PunderWorks/DroidPowerSense/PCB/production/bom/DroidPowerSense-bom.csv

Refs | Quantity | Value | Footprint | MF | MPN | LCSC | Mouser | DigiKey | Hand | DNP
R10,R12,R14,R17,R18 | 5 | 100kΩ | Resistor_SMD:R_0603_1608Metric | YAGEO | RC0603FR-07100KL | C14675 | 603-RC0603FR-07100KL | 311-100KHRCT-ND
C1,C10,C13,C14,C15,C2,C4,C5,C8 | 9 | 100nF | Capacitor_SMD:C_0603_1608Metric | Murata Electronics | GRM188R72A104KA35D | C77058 | 81-GRM188R72A104KA35 | 490-3285-1-ND
R15,R20,R23,R24,R25,R27,R5,R7,R9 | 9 | 10kΩ | Resistor_SMD:R_0603_1608Metric | YAGEO | RC0603FR-0710KL | C98220 | 603-RC0603FR-0710KL | 311-10.0KHRCT-ND
C9 | 1 | 10nF | Capacitor_SMD:C_0603_1608Metric | Samsung Electro-Mechanics | CL10B103KB8NNNC | C1589 | 187-CL10B103KB8NNNC | 1276-1009-1-ND
C11,C12,C6,C7 | 4 | 10µF | Capacitor_SMD:C_1206_3216Metric | Samsung Electro-Mechanics | CL31A106KBHNNNE | C13585 | 187-CL31A106KBHNNNE | 1276-2876-1-ND
L1 | 1 | 10µH | Inductor_SMD:L_Bourns_SRN6045TA | Bourns | SRN6045TA-100M | C2046332 | 652-SRN6045TA-100M | SRN6045TA-100MCT-ND
R28 | 1 | 120Ω | Resistor_SMD:R_0805_2012Metric | YAGEO | RC0805FR-07120RL | C114245 | 603-RC0805FR-07120RL | 311-120CRCT-ND
R8 | 1 | 180kΩ | Resistor_SMD:R_0603_1608Metric | YAGEO | RC0603FR-07180KL | C123419 | 603-RC0603FR-07180KL | 311-180KHRCT-ND
D4 | 1 | 1N4148W-TP | Diode_SMD:D_SOD-123 | Micro Commercial Components | 1N4148W-TP | C77978 | 833-1N4148W-TP | 1N4148W-TPMSCT-ND
R2,R26,R30 | 3 | 1kΩ | Resistor_SMD:R_0603_1608Metric | YAGEO | RC0603FR-071KL | C22548 | 603-RC0603FR-071KL | 311-1.00KHRCT-ND
R13 | 1 | 1mΩ | Resistor_SMD:R_2512_6332Metric | Bourns | CSS2H-2512R-1L00F | C4175647 | 652-CSS2H-2512R1L00F | CSS2H-2512R-1L00FCT-ND
J10,J11 | 2 | 1x9 socket | DroidPowerSense:PinSocket_1x09_P2.54mm_Vertical_NoPads | Sullins Connector Solutions | PPPC091LFBN-RC | C5362844 |  | S7042-ND | Yes | Yes
R1 | 1 | 2.2kΩ | Resistor_SMD:R_0603_1608Metric | YAGEO | RC0603FR-072K2L | C114662 | 603-RC0603FR-072K2L | 311-2.20KHRCT-ND
C3 | 1 | 2.2µF | Capacitor_SMD:C_0603_1608Metric | Samsung Electro-Mechanics | CL10A225KO8NNNC | C23630 | 187-CL10A225KO8NNNC | 1276-1119-1-ND
R16 | 1 | 3.3Ω | Resistor_SMD:R_1206_3216Metric | YAGEO | RC1206FR-073R3L | C137283 | 603-RC1206FR-073R3L | 311-3.30FRCT-ND
R4,R6 | 2 | 33kΩ | Resistor_SMD:R_0603_1608Metric | YAGEO | RC0603FR-0733KL | C126359 | 603-RC0603FR-0733KL | 311-33.0KHRCT-ND
J9 | 1 | 3V3 | VIO | 5V | Connector_PinHeader_2.54mm:PinHeader_1x03_P2.54mm_Vertical | Würth Elektronik | 61300311121 | C2915006 | 710-61300311121 | 732-5316-ND | Yes | Yes
R21,R22,R29,R31,R32 | 5 | 4.7kΩ | Resistor_SMD:R_0603_1608Metric | YAGEO | RC0603FR-074K7L | C99782 | 603-RC0603FR-074K7L | 311-4.70KHRCT-ND
R11,R3 | 2 | 47kΩ | Resistor_SMD:R_0603_1608Metric | YAGEO | RC0603FR-0747KL | C105579 | 603-RC0603FR-0747KL | 311-47.0KHRCT-ND
R19 | 1 | 56.2kΩ | Resistor_SMD:R_0603_1608Metric | YAGEO | RC0603FR-0756K2L | C482887 | 603-RC0603FR-0756K2L | 311-56.2KHRCT-ND
D2,D3 | 2 | B160-13-F | Diode_SMD:D_SMA | Diodes Incorporated | B160-13-F | C24784 | 621-B160-F | B160-FDICT-ND
D7 | 1 | B360A-13-F | Diode_SMD:D_SMA | Diodes Incorporated | B360A-13-F | C94193 | 621-B360A-F | B360A-FDICT-ND
D5 | 1 | B560C-13-F | Diode_SMD:D_SMC | Diodes Incorporated | B560C-13-F | C85100 | 621-B560C-F | B560C-FDICT-ND
Q4,Q5,Q6,Q7 | 4 | BSS138 | Package_TO_SOT_SMD:SOT-23 | Diodes Incorporated | BSS138-7-F | C40912 | 621-BSS138-7-F | BSS138-7-FDICT-ND
J7 | 1 | CAN_TERM | Connector_PinHeader_2.54mm:PinHeader_1x02_P2.54mm_Vertical | Würth Elektronik | 61300211121 | C2915055 | 710-61300211121 | 732-5315-ND | Yes | Yes
J4 | 1 | CIRCUIT_ID | Connector_PinHeader_2.54mm:PinHeader_1x02_P2.54mm_Vertical | Würth Elektronik | 61300211121 | C2915055 | 710-61300211121 | 732-5315-ND | Yes | Yes
Q1,Q2 | 2 | CSD18532Q5B | VSON-CLIP-8 5x6mm (DNK) | Package_TO_SOT_SMD:TDSON-8-1 | Texas Instruments | CSD18532Q5B | C882766 | 595-CSD18532Q5B | 296-42322-1-ND
U4 | 1 | ESP32-C5-Zero-M | DroidPowerSense:Waveshare_ESP32-C5-Zero-M_Socketed | Waveshare | ESP32-C5-Zero-M |  |  |  | Yes | Yes
U2 | 1 | INA237 | Package_SO:TSSOP-10_3x3mm_P0.5mm | Texas Instruments | INA237AIDGSR | C2864837 | 595-INA237AIDGSR | 296-INA237AIDGSRCT-ND
J5,J6,J8 | 3 | JST XH 2-pin | Connector_JST:JST_XH_B2B-XH-A_1x02_P2.50mm_Vertical | JST | B2B-XH-A(LF)(SN) | C158012 |  | 455-2247-ND | Yes | Yes
J3 | 1 | JST XH 4-pin | Connector_JST:JST_XH_B4B-XH-A_1x04_P2.50mm_Vertical | JST | B4B-XH-A(LF)(SN) | C144395 | 306-B4BXHALFSN |  | Yes | Yes
SH1,SH2,SH3 | 3 | Jumper shunt for 2.54mm PinHeader | DroidPowerSense:BOM_Only_JumperShunt | Würth Elektronik | 60900213421 |  | 710-60900213421 | 732-2678-ND | Yes | Yes
U1 | 1 | LM5060MM/NOPB | Package_SO:TSSOP-10_3x3mm_P0.5mm | Texas Instruments | LM5060MM/NOPB | C74456 | 926-LM5060MM/NOPB | LM5060MM/NOPBCT-ND
U3 | 1 | LMR14030SDDAR | HSOIC-8 PowerPAD (DDA) | Package_SO:TI_SO-PowerPAD-8_ThermalVias | Texas Instruments | LMR14030SDDAR | C182078 | 595-LMR14030SDDAR | 296-42492-1-ND
D8 | 1 | LTST-C190KGKT | LED_SMD:LED_0603_1608Metric | Lite-On | LTST-C190KGKT | C125094 | 859-LTST-C190KGKT | 160-1435-1-ND
Q3 | 1 | MMBT3904 | Package_TO_SOT_SMD:SOT-23 | onsemi | MMBT3904LT1G | C81464 | 863-MMBT3904LT1G | MMBT3904LT1GOSCT-ND
D6 | 1 | SMBJ33CA-13-F | Diode_SMD:D_SMB | Diodes Incorporated | SMBJ33CA-13-F | C135068 | 621-SMBJ33CA-F | SMBJ33CA-FDICT-ND
D1 | 1 | SMCJ33CA-13-F | Diode_SMD:D_SMC | Diodes Incorporated | SMCJ33CA-13-F | C135163 | 621-SMCJ33CA-F | SMCJ33CA-FDICT-ND
U5 | 1 | TCAN334G | Package_SO:SOIC-8_3.9x4.9mm_P1.27mm | Texas Instruments | TCAN334GDR | C189939 | 595-TCAN334GDR | 296-43570-1-ND
J2 | 1 | XT60PW-F | DroidPowerSense:AMASS_XT60PW-F_1x02_P7.20mm_Horizontal | Amass | XT60PW-F | C428722 |  | 4786-XT60PW-F-ND | Yes | Yes
J1 | 1 | XT60PW-M | DroidPowerSense:AMASS_XT60PW-M_1x02_P7.20mm_Horizontal | Amass | XT60PW-M | C98732 |  | 4786-XT60PW-M-ND | Yes | Yes
