PunderWorks/DroidPowerSense/PCB/DroidPowerSense.kicad_pcb

## KiCad design PCB/DroidPowerSense.kicad_pcb (2026-11-10)

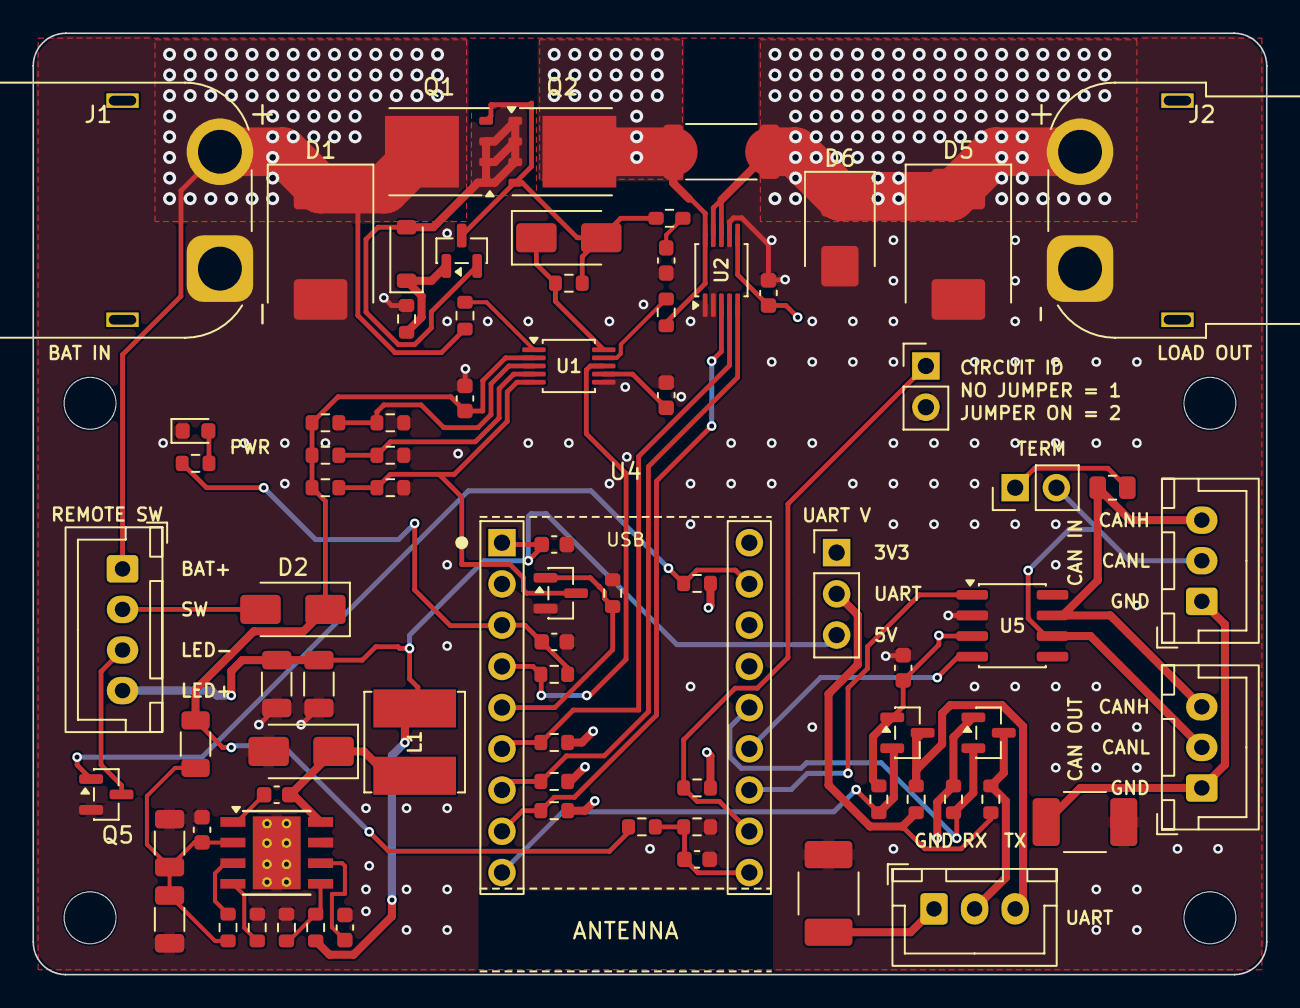
[picture p3: board DroidPowerSense.kicad_pcb from above]

Board: 4 copper layers, 76.0 x 58.0 mm, 89 parts (1 on the bottom side), 48 nets.

Parts:
C1, C2, C4, C5, C8, C10, C13, C14, C15: 100nF; C_0603_1608Metric
C3: 2.2µF; C_0603_1608Metric
C6, C7, C11, C12: 10µF; C_1206_3216Metric
C9: 10nF; C_0603_1608Metric
D1: SMCJ33CA-13-F; D_SMC
D2, D3: B160-13-F; D_SMA
D4: 1N4148W-TP; D_SOD-123
D5: B560C-13-F; D_SMC
D6: SMBJ33CA-13-F; D_SMB
D7: B360A-13-F; D_SMA
D8: LTST-C190KGKT; LED_0603_1608Metric
F1, F2: MF-MSMF014/60X-2; Bourns_MF-MSMF_1812_Style2
H1, H2, H3, H4: M3; MountingHole_3.2mm_M3
J1: XT60PW-M; AMASS_XT60PW-M_1x02_P7.20mm_Horizontal
J2: XT60PW-F; AMASS_XT60PW-F_1x02_P7.20mm_Horizontal
J3: JST XH 4-pin; JST_XH_B4B-XH-A_1x04_P2.50mm_Vertical
J4: CIRCUIT_ID; PinHeader_1x02_P2.54mm_Vertical
J5, J6, J8: JST XH 3-pin; JST_XH_B3B-XH-A_1x03_P2.50mm_Vertical
J7: CAN_TERM; PinHeader_1x02_P2.54mm_Vertical
J9: 3V3 | VIO | 5V; PinHeader_1x03_P2.54mm_Vertical
J10, J11: 1x9 socket; PinSocket_1x09_P2.54mm_Vertical_NoPads
L1: 10µH; L_Bourns_SRN6045TA
LOGO**: PunderWorks_Logo_14mm
Q1, Q2: CSD18532Q5B | VSON-CLIP-8 5x6mm (DNK); TDSON-8-1
Q3: MMBT3904; SOT-23
Q4, Q5, Q6, Q7: BSS138; SOT-23
R1: 2.2kΩ; R_0603_1608Metric
R2, R26, R30: 1kΩ; R_0603_1608Metric
R3, R11: 47kΩ; R_0603_1608Metric
R4, R6: 33kΩ; R_0603_1608Metric
R5, R7, R9, R15, R20, R23, R24, R25, R27: 10kΩ; R_0603_1608Metric
R8: 180kΩ; R_0603_1608Metric
R10, R12, R14, R17, R18: 100kΩ; R_0603_1608Metric
R13: 1mΩ; R_2512_6332Metric
R16: 3.3Ω; R_1206_3216Metric
R19: 56.2kΩ; R_0603_1608Metric
R21, R22, R29, R31, R32: 4.7kΩ; R_0603_1608Metric
R28: 120Ω; R_0805_2012Metric
SH1, SH2, SH3: Jumper shunt for 2.54mm PinHeader; BOM_Only_JumperShunt
U1: LM5060MM/NOPB; TSSOP-10_3x3mm_P0.5mm
U2: INA237; TSSOP-10_3x3mm_P0.5mm
U3: LMR14030SDDAR | HSOIC-8 PowerPAD (DDA); TI_SO-PowerPAD-8_ThermalVias
U4: ESP32-C5-Zero-M; Waveshare_ESP32-C5-Zero-M_Socketed
U5: TCAN334G; SOIC-8_3.9x4.9mm_P1.27mm

Connections:
+3V3: C4.1, C14.1, C15.1, J9.1, Q6.1, Q7.1, R21.2, R22.2, R23.2, R24.2, R25.2, R26.1, R27.2, R29.2, R31.2, U2.6, U4.3, U5.3
+5V: C11.1, C12.1, C13.1, J3.4, J9.3, L1.2, R19.1, U4.1
BUCK_BOOT: C10.1, U3.1
BUCK_EN: R17.2, U3.3
BUCK_FB: R19.2, R20.1, U3.5
BUCK_RT: R18.1, U3.4
BUCK_SS: C9.1, U3.6
BUCK_SW: C10.2, D7.1, L1.1, U3.8
BUCK_VIN: C6.1, C7.1, C8.1, R16.2, R17.1, U3.2
CANH: J5.3, J6.3, R28.1, U5.7
CANL: J5.2, J6.2, J7.2, U5.6
CAN_GND: F1.1, J5.1, J6.1
CAN_RX: U4.13, U5.4
CAN_TX: U4.12, U5.1
CIRCUIT_ID: J4.1, R25.1, U4.11
GATE_C: C2.1, R2.2
GATE_DRV: D3.1, R1.1, U1.10
GATE_FET: D3.2, Q1.4, Q2.4, Q3.3, R1.2, R2.1
GND: C1.2, C2.2, C3.2, C4.2, C5.2, C6.2, C7.2, C8.2, C9.2, C11.2, C12.2, C13.2, C14.2, C15.2, D1.2, D5.2, D6.2, D7.2, D8.1, F1.2, F2.2, J1.1, J2.1, J4.2, Q4.2, Q5.2, R3.2, R7.2, R9.2, R11.2, R12.2, R15.2, R18.2, R20.2, U1.6, U2.1, U2.2, U2.7, U3.7, U3.9, U4.2, U5.2
I2C_SCL: R22.1, U2.5, U4.7
I2C_SDA: R21.1, U2.4, U4.6
INA_ALERT: R23.1, U2.3, U4.8
unnamed: J7.1, R28.2
PROT_EN: Q4.3, R10.2, R11.1, U1.5
PROT_OUT: R5.2, U1.9
PROT_OVP: R8.2, R9.1, U1.3
PROT_SENSE: R4.2, U1.1
PROT_TIMER: C3.1, U1.7
PROT_UVLO: R6.2, R7.1, U1.4
PWR_CUTOFF: Q4.1, R12.1, U4.5
PWR_LED_A: D8.2, R26.2
PWR_PGOOD: R24.1, U1.8, U4.4
REV_BASE: D4.1, Q3.1, R3.1
SW_LED_EN: Q5.1, R27.1, U4.17
SW_LED_K: J3.3, Q5.3
UART_GND: F2.1, J8.1
UART_RX: J8.2, Q7.3, R32.2
UART_RX_3V3: Q7.2, R31.1, U4.14
UART_TX: J8.3, Q6.3, R30.2
UART_TX_3V3: Q6.2, R29.1, U4.9
UART_VIO: J9.2, R30.1, R32.1
VBAT_ADC: C5.1, R14.2, R15.1, U4.10
VBAT_IN: D1.1, J1.2, J3.1, Q1.5, R4.1
VOUT: D5.1, D6.1, J2.2, R13.2, U2.8, U2.9
VSW_CTRL: C1.1, D2.1, R6.1, R8.1, R10.1, R14.1, R16.1, U1.2
VSW_MID: D4.2, Q1.1, Q1.2, Q1.3, Q2.1, Q2.2, Q2.3, Q3.2
VSW_OUT: Q2.5, R5.1, R13.1, U2.10
VSW_RAW: D2.2, J3.2
