PunderWorks/DroidPowerSense/(commit log)

2026-11-07 Initial DroidPowerSense hardware design
    Inline 9-32 V battery sense and protection board for droid builds:
    XT60 in/out, LM5060 + back-to-back CSD18532Q5B switch with zero
    off-state drain, INA226 on a 1 mOhm shunt, LMR14030 5 V buck,
    Waveshare ESP32-C5-Zero, TCAN334G CAN FD and level-shifted UART.
    - Stackup KDL design (PCB/stackup) with the synced 4-layer KiCad board,
    custom footprints, 3D models and manufacturer datasheets
    - Remote switch connector J3 is a 4-pin JST-XH (BAT+, SW, LED-, LED+)
    supporting lit-when-on switches; Q_LED on IO12 drives the light
    - Silkscreen: pin functions in line with every JST pin, CAN IN / CAN
    OUT markings, plain-language circuit ID jumper instructions
    - n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
2026-11-07 Move CI actions off deprecated Node 20 (#2)
    actions/checkout v4 -> v7 and dorny/paths-filter v3 -> v4; both run on
    node24. checkout v7's breaking change only blocks fork checkouts under
    pull_request_target / workflow_run, which this workflow doesn't use.
2026-11-08 Compact the board to 70 x 50 mm with the ESP32 on sockets (#3)
    * Compact the board to 70 x 50 mm with the ESP32 on sockets
    Placement and pours for a 70 x 50 mm board (was 90 x 66). Signal routing
    is left to be done by hand in KiCad.
    - ESP32-C5-Zero-M (pre-soldered headers) in two 1x9 sockets (Sullins
    PPPC091LFBN-RC): the module sits ~11 mm up, so USB-C clears the board,
    low parts fit under it, and it can be swapped. The sockets are pinless
    BOM parts sharing the module footprint's holes.
    - XT60 bodies overhang the side edges ~5 mm so the TVS, FETs, shunt and
    flyback diode fit in one row between them.
    - Power pours on F.Cu/In2.Cu/B.Cu with 85 stitching vias, GND planes,
    In2 VSW_CTR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
2026-11-08 Validate power switch and UART level shifter with SPICE and SOA models (#4)
    - Implement soa.py and test_soa.py: Safe Operating Area power evaluation
    and thermal moving-window integrator for CSD18532Q5B and SMBJ33CA
    transient curves with 10 unit tests.
    - Upgrade power_switch_sim.py: LM5060 charge pump and fault latch models
    covering sw_open, turn_on, mcu_cutoff, reverse_pol, inrush into
    capacitive loads (100 uF to 10 mF), hot-FET 30 A continuous margin,
    120 A overload vs dead short, and motor regeneration back-EMF.
    - Implement uart_shifter_sim.py: bidirectional BSS138 level shifter
    verification across 3.3 V / 5.0 V VIO, threshold corners, 115.2 kbps
    and 1.0 Mbps, and cable capac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
2026-11-08 hardware: add gate dV/dt slew components, update R_SENSE and C_TIMER (#5)
    - Add gate dV/dt network: C_GATE (220 nF 50V X7R 0603) and R_GATE_C (1 kΩ 0603)
    between GATE_FET and GND to control gate slew rate and limit capacitive inrush.
    - Update R_SENSE to 33 kΩ to clear 30 A continuous rating under worst-case 100°C
    hot FET R_DS(on) without false V_DS trips.
    - Update C_TIMER to 2.2 µF to accommodate gate soft-start into large capacitor
    banks without timing out into a fault.
    - Sync and route changes in PCB/DroidPowerSense.kicad_pcb with 0 DRC violations
    and 0 unconnected items.
    - Update baseline VALUES in scripts/spice/power_switch_sim.py and documentation in
    PCB/README.md.
2026-11-08 Fix pre-fab review findings and add fab files (#6)
    * Fix pre-fab review findings and add fab files
    Start-up fault: C_GATE 220 nF could let the LM5060 start-up timer expire
    before the gate finished at 32 V (worst case 0.55 s gate ramp vs 0.48 s
    timer). C_GATE is now 100 nF / 100 V (0.25 s); every 100 nF on the board
    uses the 100 V part. Load capacitance is rated to 4.7 mF at 32 V.
    Overvoltage exposure:
    - INA226 -> INA237 (85 V common-mode, same DGS pinout, A0/A1 to GND).
    - R_BUCK_IN 3.3 Ohm ahead of the LMR14030 input capacitors (new BUCK_VIN
    net) filters surges above its 44 V VIN/EN rating.
    Board:
    - Physical stackup corrected to the 6-layer 1.6 mm build.
    - Board name, revision and date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
2026-11-08 Refill zones and regenerate fab files from the refilled board (#7)
    The board committed in #6 carried pour fills from before R_BUCK_IN and
    the BUCK_VIN re-route: the edit scripts saved without refilling, and DRC
    only refilled in memory. kicad-cli plots stored fills, so all six copper
    Gerbers in PCB/production/ were stale. Refilled with kicad-cli (identical
    to KiCad's own refill), DRC 0/0, and every fab file regenerated. README:
    refill-and-save is now the first step of the regenerate commands.
2026-11-08 Confirm the ESP32 socket height from Sullins' catalog (#8)
    PPPC091LFBN-RC: .335" [8.50 mm] insulator, 6.0 mm insertion depth,
    Ø1.02 mm recommended hole (catalog p. 114-115, now in datasheets/).
    Replaces the README note that the height was inferred from the part
    number.
2026-11-08 Widen the last 0.18 mm tracks to 0.2 mm and regenerate fab files (#9)
    The I²C pair from the INA237 and the B.Cu INA_ALERT run were re-routed
    so every track is at least 0.2 mm wide with 0.2 mm clearance (DRC 0/0,
    fills refilled). Gerbers and drills regenerated from the updated board;
    BOM and placement are unchanged.
2026-11-08 Record firmware requirements from the hardware design (#10)
    docs/firmware-requirements.md collects what the board relies on firmware
    for: INA237 ALERT -> PWR_CUTOFF as the primary overcurrent protection, no
    cutoff during regen, clearing the LM5060 fault latch via EN, the pin map,
    INA237 setup (0x40, its own register map, SHUNT_CAL/SOVL values), battery
    ADC, lit-switch LED, CAN/UART, and GPIO26 antenna select. Linked from
    AGENTS.md and the PCB README.
2026-11-08 Expand the README with board renders, wiring and specs (#11)
    Front and back renders, what the board does, how it wires into a droid
    (including the required upstream fuse), specifications, connectors and
    jumpers, remote-switch wiring, pre-power-up notes, project status, repo
    layout, design workflow and ordering notes. Updated renders of the
    70 x 50 mm board.
2026-11-08 Add PunderWorks logo footprints and the fused-lead recommendation (#12)
    Logo: board-only silkscreen footprints at 10, 14 and 18 mm wide,
    generated from the logo PNG by scripts/make_logo_footprint.py (opaque
    pixels merged into filled rectangles; min stroke 0.31-0.56 mm). Not yet
    placed on the board.
    Fuse: README and PCB README now recommend an XT60 battery lead with an
    in-line blade fuse (30 A, 40 A max) and a 22 AWG or heavier remote-switch
    lead, so the battery fuse also covers the J3 BAT+ lead. Records why
    on-board PTC/eFuse protection was set aside.
2026-11-08 Final silkscreen: logo, QR code, board title; regenerate fab files (#13)
    Back silkscreen: PunderWorks logo (14 mm), a QR code to
    github.com/PunderWorks/DroidPowerSense (10.2 mm), and the board title
    and repo URL. The BUCK_VIN and SW_LED_EN vias under the QR code were
    moved and re-routed to give it clear space. DRC 0/0 with no exclusions,
    fills refilled, PCB sync clean. Gerbers and drills regenerated (BOM and
    placement unchanged: the logo and QR code are board-only). Updated rear
    render and README status.
2026-11-10 Update Stackup to 0.3.0 and mark hand parts in KiCad (#14)
    Stackup 0.3.0's sync marks every `hand=#true` footprint Exclude from
    position files and Exclude from BOM. Resynced the board: the 15
    hand-installed parts (XT60s, JST and pin headers, MCU sockets, module,
    shunts) now drop out of `kicad-cli pcb export pos` and the PCBWay plugin's
    BOM and placement files on their own, so the manual trimming step is gone.
    The regenerated placement file has the same 67 rows; only kicad-cli's
    quoting differs from the hand-trimmed copy. The purchasing BOM is unchanged.
    No copper changed, so the Gerbers stand.
2026-11-10 Move to 4 layers at 76 x 58 mm and add ground pins to CAN/UART (#15)
    * Move to 4 layers at 76 x 58 mm and add ground pins to CAN/UART
    The 70 x 50 mm board needed 6 layers to route; at 76 x 58 mm it fits on
    4 (F.Cu / In1 GND / In2 power pours, +3V3 and VSW_CTRL / B.Cu), which
    is cheaper to fab. The power row grows from 8.7 to 11.2 mm so three
    power layers (2+1+2 oz) match the copper the 6-layer board had in four.
    - scripts/layout_4layer.py moves the hand-placed parts and silkscreen by
    region, rebuilds the outline, pours and stitching vias, and swaps the
    stackup to 4 layers. The old routing is removed: signal routing is to
    be redone by hand (114 unrouted, DRC otherwise clean).
    - J_CAN1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
2026-11-10 refactor: update renders (#16)
    this just updates the renders to match the PCB layout
2026-11-10 Order with 1 oz copper and recommend the heatsink above ~15 A continuous (#17)
    2 oz outer copper doubled the fab price, and a droid's average load is under
    1 A with 30 A continuous a rare ceiling. With 1 oz outer copper the 30 A path
    carries ~0.46 W in its copper instead of ~0.27 W, small next to the FETs'
    5-8 W; what it loses is heat spreading around the FETs and shunt.
    - Board stackup: outer copper 0.035 mm, prepregs 0.2454 mm to keep 1.6 mm.
    The Gerber job file now reports 1 oz; copper layers are unchanged.
    - PCB/README.md: fab spec with the 1 oz vs 2 oz numbers, cross-sections at
    1 oz, and a load-versus-heat table behind the ~15 A heatsink guidance.
    - README.md: board spec, fab note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
